artemdev9/Smart_lamp/Project_code/Project_code.ino

#include <FastLED.h>
#include <TimeLib.h>

#define TIME_HEADER  "T"   
#define TIME_REQUEST  7    

#define NUM_LEDS 9

#define data0 0
#define data1 1
#define data2 2
#define data3 3
#define data4 4
#define data5 5
#define data6 6
#define data7 7
#define data8 8
#define data9 9
#define data10 10

#define ldrPin A0

CRGB leds0[NUM_LEDS];
CRGB leds1[NUM_LEDS];
CRGB leds2[NUM_LEDS];
CRGB leds3[NUM_LEDS];
CRGB leds4[NUM_LEDS];
CRGB leds5[NUM_LEDS];
CRGB leds6[NUM_LEDS];
CRGB leds7[NUM_LEDS];
CRGB leds8[NUM_LEDS];
CRGB leds9[NUM_LEDS];
CRGB leds10[NUM_LEDS];
int ambcount;
int thresh = 1000;

void setup() {
  FastLED.addLeds<WS2812, data0, RGB>(leds0, NUM_LEDS); // GRB ordering is assumed
  FastLED.addLeds<WS2812, data1, RGB>(leds1, NUM_LEDS); 
  FastLED.addLeds<WS2812, data2, RGB>(leds2, NUM_LEDS); 
  FastLED.addLeds<WS2812, data3, RGB>(leds3, NUM_LEDS); 
  FastLED.addLeds<WS2812, data4, RGB>(leds4, NUM_LEDS); 
  FastLED.addLeds<WS2812, data5, RGB>(leds5, NUM_LEDS);
  FastLED.addLeds<WS2812, data6, RGB>(leds6, NUM_LEDS); 
  FastLED.addLeds<WS2812, data7, RGB>(leds7, NUM_LEDS);
  FastLED.addLeds<WS2812, data8, RGB>(leds8, NUM_LEDS); 
  FastLED.addLeds<WS2812, data9, RGB>(leds9, NUM_LEDS); 
  FastLED.addLeds<WS2812, data10, RGB>(leds10, NUM_LEDS); 

  Serial.begin(9600);
  while (!Serial) ; 

  Serial.println("Waiting for sync message");

  pinMode( ldrPin, INPUT );

  ambcount = 0;

}

void loop() {
  if (Serial.available()) {
    //processSyncMessage();
  }
  if (timeStatus() != timeNotSet) {
    //digitalClockDisplay();
  }

  int hours = hour() + 1;
  int mins = minute();

  int minTens;
  int minOnes;
  int hrTens;
  int hrOnes;

  minTens = mins / 10;
  minOnes = mins % 10;
  hrTens = hours / 10;
  hrOnes = hours % 10;

  int ldr = analogRead( ldrPin );
  Serial.println(ldr);

  //if (ldr <= thresh) {
    lb();
    FastLED.clear();

    //showtimeM(minOnes, 5);
    //showtimeM(minTens, 0);
    //showtimeH(hrOnes, 5);
    //showtimeH(hrTens, 0);

    FastLED.show();
   // mb();
  //} else if (ldr > thresh) {
    amb();
  //}

}



void amb() {

  if (ambcount == 0) {
    lb();
    violet();
    mb();

    ambcount++;
  } else if (ambcount == 1) {
    lb();
    orange();
    mb();

    ambcount++;
  } else if (ambcount == 2) {
    lb();
    teal();
    mb();

    ambcount++;
  } else if (ambcount == 3) {
    lb();
    blue();
    mb();

    ambcount++;
  } else if (ambcount == 4) {
    lb();
    green();
    mb();

    ambcount++;
  } else if (ambcount == 5) {
    lb();
    yellow();
    mb();

    ambcount++;
  } else if (ambcount == 6) {
    lb();
    rainbow_right_to_left();
    lb();
    mb();

    ambcount++;
  } else if (ambcount == 7) {
    lb();
    violet();
    mb();

    ambcount++;
  } else if (ambcount == 8) {
    lb();
    orange();
    mb();

    ambcount++;
  } else if (ambcount == 9) {
    lb();
    teal();
    mb();

    ambcount++;
  } else if (ambcount == 10) {
    lb();
    blue();
    mb();

    ambcount++;
  } else if (ambcount == 11) {
    lb();
    green();
    mb();

    ambcount++;
  } else if (ambcount == 12) {
    lb();
    yellow();
    mb();

    ambcount++;
  } else if (ambcount == 13) {
    mb();
    squares();
    lb();
    mb();

    ambcount = 0;
  }

}


void squares() {

  FastLED.clear();
  FastLED.setBrightness(255);

  // green
  for (int i = 0; i < 4; i++ ) {
    leds0[i] = CRGB(255, 0, 0); // grb
    leds1[i] = CRGB(255, 0, 0);
    leds2[i] = CRGB(255, 0, 0);
    leds3[i] = CRGB(255, 0, 0);
    leds4[i] = CRGB(255, 0, 0);
    leds5[i] = CRGB(255, 255, 255);
    leds6[i] = CRGB(255, 0, 0);
    leds7[i] = CRGB(255, 0, 0);
    leds8[i] = CRGB(255, 0, 0);
    leds9[i] = CRGB(255, 0, 0);
    leds10[i] = CRGB(255, 0, 0);

    FastLED.show();
    delay(200);

  }

  //red
  for (int i = 8; i > 4; i-- ) {
    leds0[i] = CRGB(0, 255, 0);  // grb
    leds1[i] = CRGB(0, 255, 0);
    leds2[i] = CRGB(0, 255, 0);
    leds3[i] = CRGB(0, 255, 0);
    leds4[i] = CRGB(0, 255, 0);
    leds5[i] = CRGB(255, 255, 255);
    leds6[i] = CRGB(0, 255, 0);
    leds7[i] = CRGB(0, 255, 0);
    leds8[i] = CRGB(0, 255, 0);
    leds9[i] = CRGB(0, 255, 0);
    leds10[i] = CRGB(0, 255, 0);

    FastLED.show();
    delay(200);

  }

  // blue
  for (int i = 0; i < 4; i++ ) {
    leds0[i] = CRGB(0, 0, 255); // grb
  }
  leds0[4] = CRGB(255, 255, 255);
  FastLED.show();
  delay(200);
  for (int i = 0; i < 4; i++ ) {
    leds1[i] = CRGB(0, 0, 255);
  }
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
  Serial.print(minute());
  Serial.print(" ");
}


void processSyncMessage() { 
  unsigned long pctime;
  const unsigned long DEFAULT_TIME = 1357041600; 

  if (Serial.find(TIME_HEADER)) {
    pctime = Serial.parseInt();
    if ( pctime >= DEFAULT_TIME) { 
      setTime(pctime); 
    }
  }
}
